701lab/SlaveBMS/Additional cascades (may be useful).brd

## EAGLE design Additional cascades (may be useful).brd (2019-11-22)

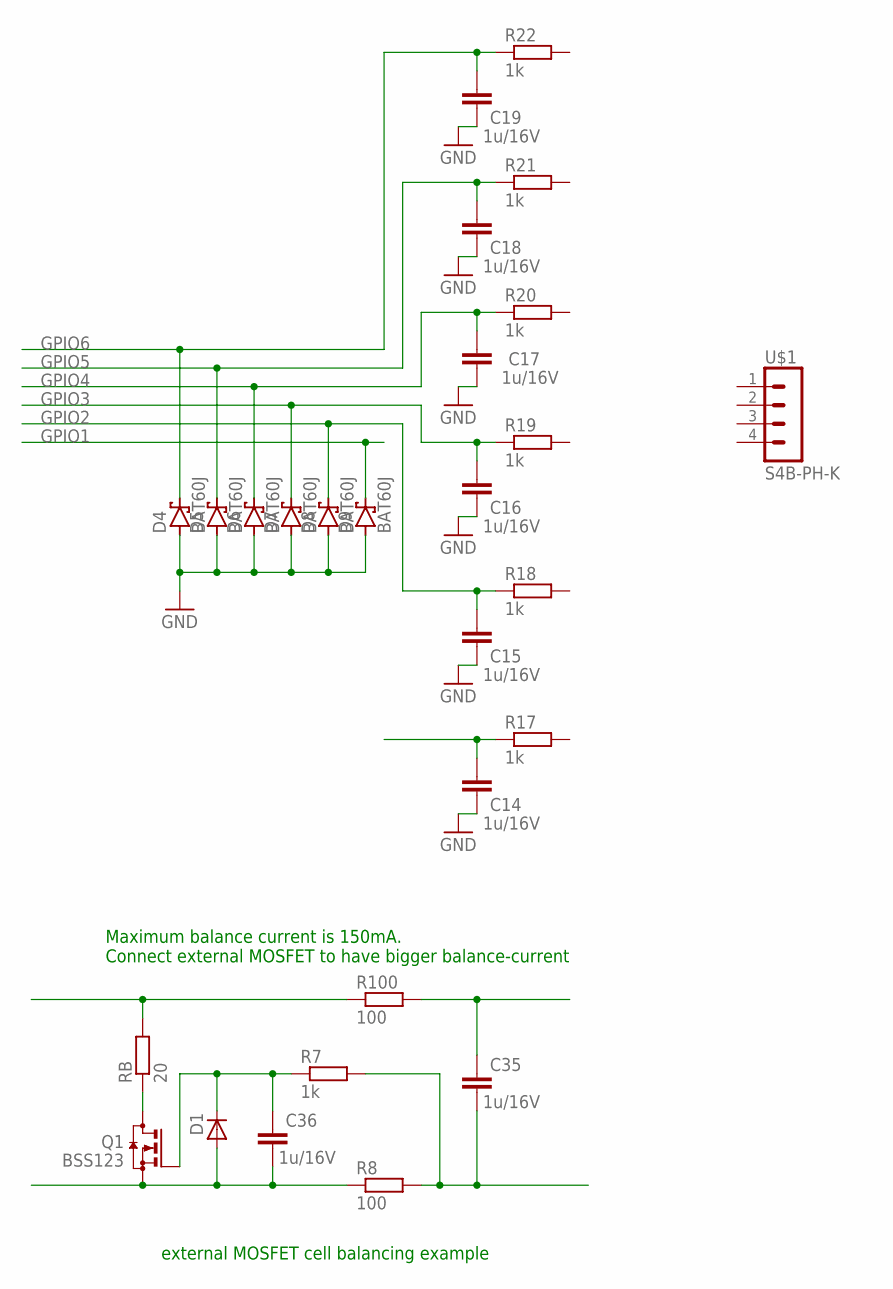
[picture p1: schematic Additional cascades (may be useful).sch]

Parts:
C14, C15, C16, C17, C18, C19, C35, C36: 1u/16V; C0603
D1: DIODE_E-; DIODE_SMB
D4, D5, D6, D7, D8, D9: BAT60J; SOD323_ST
Q1: BSS123; SOT23
R7, R17, R18, R19, R20, R21, R22: 1k; R0603
R8, R100: 100; R0603
RB: 20; R0603
U$1: S4B-PH-K

Connections:
GND: C14.1, C15.1, C16.1, C17.1, C18.1, C19.1, D4.A, D5.A, D6.A, D7.A, D8.A, D9.A
GPIO1: C14.2, D9.C, R17.1
GPIO2: C15.2, D8.C, R18.1
GPIO3: C16.2, D7.C, R19.1
GPIO4: C17.2, D6.C, R20.1
GPIO5: C18.2, D5.C, R21.1
GPIO6: C19.2, D4.C, R22.1
unnamed: Q1.3 (D), RB.1
unnamed: R100.1, RB.2
unnamed: C35.2, R100.2
unnamed: C35.1, R7.2, R8.2
unnamed: C36.1, D1.A (C), Q1.2 (S), R8.1
unnamed: C36.2, D1.C (A), Q1.1 (G), R7.1

Notes on the sheet:
external MOSFET cell balancing example
Maximum balance current is 150mA. Connect external MOSFET to have bigger balance-current

Board: 2 copper layers, 28 parts (0 on the bottom side), 13 nets, no tracks yet.

Other parts of the board:
U$2: BMS_HIGH_COM
