701lab/SlaveBMS/Digital BMS Slave board .brd

## EAGLE design Digital BMS Slave board .brd (2019-11-09)

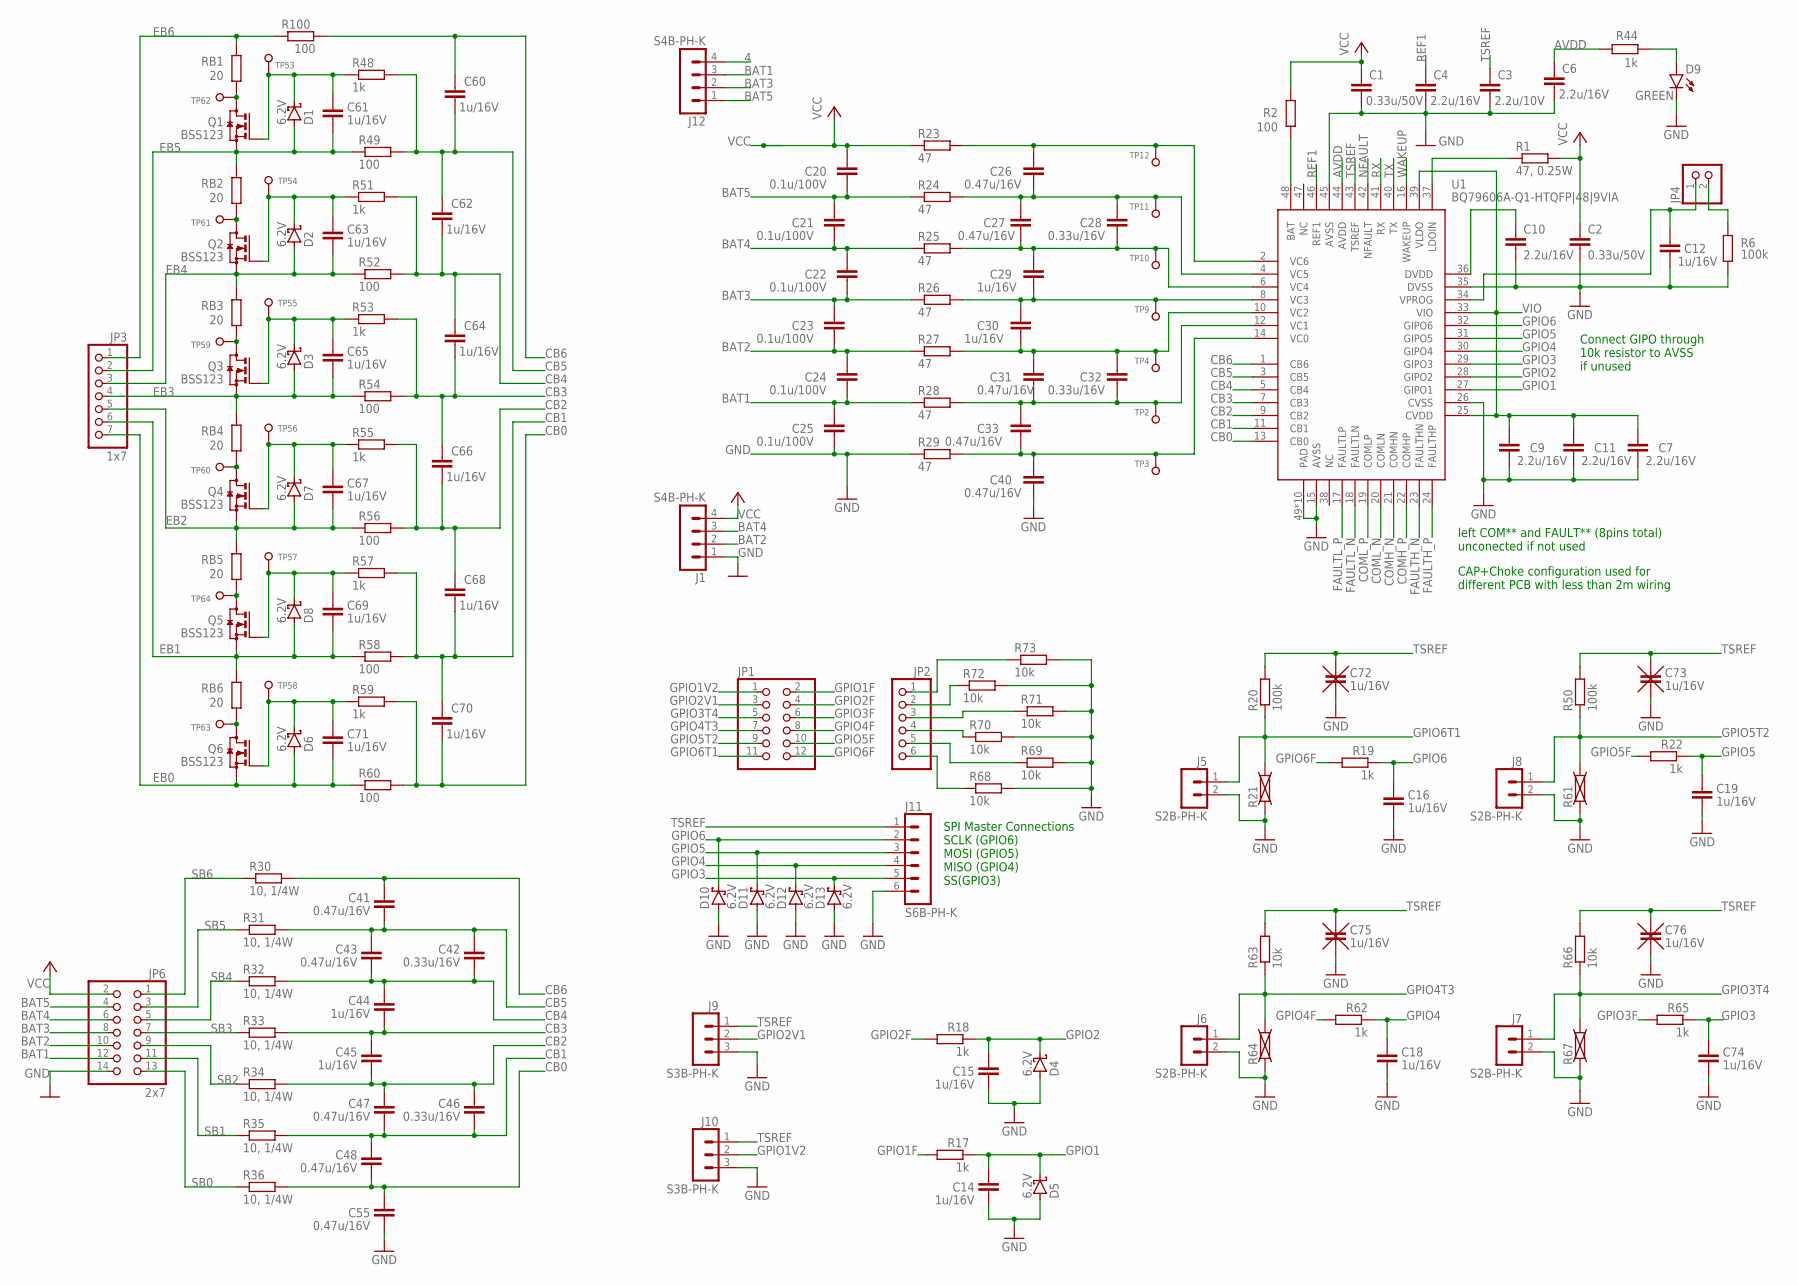
[picture p2: schematic Digital BMS Slave board .sch, sheet 1]

Parts:
C1, C2: 0.33u/50V; C1206K
C3: 2.2u/10V; C0603
C4, C6, C7, C9, C10, C11: 2.2u/16V; C0603
C12, C14, C15, C16, C18, C19, C60, C61, C62, C63, C64, C65, C66, C67, C68, C69, C70, C71, C74: 1u/16V; C0603
C20, C21, C22, C23, C24, C25: 0.1u/100V; C1206K
C26, C27, C31, C33, C40, C41, C43, C47, C48, C55: 0.47u/16V; C0603
C28, C32, C42, C46: 0.33u/16V; C0603
C29, C30, C44, C45: 1u/16V; C0805K
C72, C73, C75, C76: 1u/16V; C0603K-X
D1, D2, D3, D4, D5, D6, D7, D8, D10, D11, D12, D13: 6.2V; SOD323_ST
D9: GREEN; LED-0805
J1, J12: S4B-PH-K
J5, J6, J7, J8: S2B-PH-K
J9, J10: S3B-PH-K
J11: S6B-PH-K
JP1: PINHD-2X6; 2X06
JP2: PINHD-1X6-OCT; 1X06
JP3: 1x7; 1X07
JP4: PINHD-1X2; 1X02
JP6: 2x7; 2X07
Q1, Q2, Q3, Q4, Q5, Q6: BSS123; SOT23
R1: 47, 0.25W; R1206
R2, R49, R52, R54, R56, R58, R60, R100: 100; R0603
R6, R20, R50: 100k; R0603
R17, R18, R19, R22, R44, R48, R51, R53, R55, R57, R59, R62, R65: 1k; R0603
R21, R61, R64, R67: R-EU-X0603; R0603-X
R23, R24, R25, R26, R27, R28, R29: 47; R0603
R30, R31, R32, R33, R34, R35, R36: 10, 1/4W; R1210
R63, R66, R68, R69, R70, R71, R72, R73: 10k; R0603
RB1, RB2, RB3, RB4, RB5, RB6: 20; R2512
TP2, TP3, TP4, TP9, TP10, TP11, TP12: TEST_PAD-[1MM]; TP1MM_MASK
TP53, TP54, TP55, TP56, TP57, TP58, TP59, TP60, TP61, TP62, TP63, TP64: TEST_PAD-[1.27MM]; TP1.27MM
U1: BQ79606A-Q1-HTQFP|48|9VIA; HTQFP48-9X9MM-VIA

Connections:
4: J12.4
AVDD: C6.1, R44.2, U1.44 (AVDD)
BAT: R2.1, U1.48 (BAT)
BAT1: C24.1, C25.2, J12.3, JP6.12, R28.1
BAT2: C23.1, C24.2, J1.2, JP6.10, R27.1
BAT3: C22.1, C23.2, J12.2, JP6.8, R26.1
BAT4: C21.1, C22.2, J1.3, JP6.6, R25.1
BAT5: C20.1, C21.2, J12.1, JP6.4, R24.1
CB0: C48.1, C55.2, C70.1, R36.2, R59.2, R60.2, U1.13 (CB0)
CB1: C46.1, C47.1, C48.2, C68.1, C70.2, R35.2, R57.2, R58.2, U1.11 (CB1)
CB2: C45.1, C46.2, C47.2, C66.1, C68.2, R34.2, R55.2, R56.2, U1.9 (CB2)
CB3: C44.1, C45.2, C64.1, C66.2, R33.2, R53.2, R54.2, U1.7 (CB3)
CB4: C42.1, C43.1, C44.2, C62.1, C64.2, R32.2, R51.2, R52.2, U1.5 (CB4)
CB5: C41.1, C42.2, C43.2, C60.1, C62.2, R31.2, R48.2, R49.2, U1.3 (CB5)
CB6: C41.2, C60.2, R30.2, R100.2, U1.1 (CB6)
COMH_N: U1.21 (COMHN); also elsewhere on the board
COMH_P: U1.22 (COMHP); also elsewhere on the board
COML_N: U1.20 (COMLN); also elsewhere on the board
COML_P: U1.19 (COMLP); also elsewhere on the board
DVDD: C10.1, U1.36 (DVDD)
EB0: C71.1, D6.A, JP3.7, Q6.2 (S), R60.1
EB1: C69.1, D8.A, JP3.6, Q5.2 (S), R58.1, RB6.2
EB2: C67.1, D7.A, JP3.5, Q4.2 (S), R56.1, RB5.2
EB3: C65.1, D3.A, JP3.4, Q3.2 (S), R54.1, RB4.2
EB4: C63.1, D2.A, JP3.3, Q2.2 (S), R52.1, RB3.2
EB5: C61.1, D1.A, JP3.2, Q1.2 (S), R49.1, RB2.2
EB6: JP3.1, R100.1, RB1.2
FAULTH_N: U1.23 (FAULTHN); also elsewhere on the board
FAULTH_P: U1.24 (FAULTHP); also elsewhere on the board
FAULTL_N: U1.18 (FAULTLN); also elsewhere on the board
FAULTL_P: U1.17 (FAULTLP); also elsewhere on the board
GND: C1.1, C2.2, C3.2, C4.2, C6.2, C7.2, C9.2, C10.2, C11.2, C12.2, C14.1, C15.1, C16.1, C18.1, C19.1, C25.1, C40.1, C55.1, C72.2, C73.2, C74.1, C75.2, C76.2, D4.A, D5.A, D9.- (C), D10.A, D11.A, D12.A, D13.A, J1.1, J5.2, J6.2, J7.2, J8.2, J9.3, J10.3, J11.6, JP6.14, R6.1, R21.1, R29.1, R61.1, R64.1, R67.1, R68.2, R69.2, R70.2, R71.2, R72.2, R73.2, U1.15 (AVSS), U1.26 (CVSS), U1.35 (DVSS), U1.45 (AVSS), U1.49 (PAD), U1.491 (PAD), U1.492 (PAD), U1.493 (PAD), U1.494 (PAD), U1.495 (PAD), U1.496 (PAD), U1.497 (PAD), U1.498 (PAD), U1.499 (PAD); also elsewhere on the board
GPIO1: C14.2, D5.C, R17.1, U1.27 (GIPO1)
GPIO1F: JP1.2, R17.2
GPIO1V2: J10.2, JP1.1
GPIO2: C15.2, D4.C, R18.1, U1.28 (GIPO2)
GPIO2F: JP1.4, R18.2
GPIO2V1: J9.2, JP1.3
GPIO3: C74.2, D13.C, J11.5, R65.1, U1.29 (GIPO3)
GPIO3F: JP1.6, R65.2
GPIO3T4: J7.1, JP1.5, R66.1, R67.2
GPIO4: C18.2, D12.C, J11.4, R62.1, U1.30 (GIPO4)
GPIO4F: JP1.8, R62.2
GPIO4T3: J6.1, JP1.7, R63.1, R64.2
GPIO5: C19.2, D11.C, J11.3, R22.1, U1.31 (GIPO5)
GPIO5F: JP1.10, R22.2
GPIO5T2: J8.1, JP1.9, R50.1, R61.2
GPIO6: C16.2, D10.C, J11.2, R19.1, U1.32 (GIPO6)
GPIO6F: JP1.12, R19.2
GPIO6T1: J5.1, JP1.11, R20.1, R21.2
LDOIN: R1.1, U1.37 (LDOIN)
unnamed: JP4.2, R6.2
unnamed: Q1.3 (D), RB1.1, TP62.1
unnamed: JP2.1, R73.1
unnamed: JP2.2, R72.1
unnamed: JP2.3, R71.1
unnamed: JP2.4, R70.1
unnamed: Q3.3 (D), RB3.1, TP59.1
unnamed: JP2.5, R69.1
unnamed: JP2.6, R68.1
unnamed: D9.+ (A), R44.1
unnamed: C61.2, D1.C, Q1.1 (G), R48.1, TP53.1
unnamed: Q2.3 (D), RB2.1, TP61.1
unnamed: Q5.3 (D), RB5.1, TP64.1
unnamed: C63.2, D2.C, Q2.1 (G), R51.1, TP54.1
unnamed: C65.2, D3.C, Q3.1 (G), R53.1, TP55.1
unnamed: Q4.3 (D), RB4.1, TP60.1
unnamed: C67.2, D7.C, Q4.1 (G), R55.1, TP56.1
unnamed: C69.2, D8.C, Q5.1 (G), R57.1, TP57.1
unnamed: Q6.3 (D), RB6.1, TP63.1
unnamed: C71.2, D6.C, Q6.1 (G), R59.1, TP58.1
NFAULT: U1.42 (NFAULT); also elsewhere on the board
REF1: C4.1, U1.46 (REF1)
RX: U1.41 (RX); also elsewhere on the board
SB0: JP6.13, R36.1
SB1: JP6.11, R35.1
SB2: JP6.9, R34.1
SB3: JP6.7, R33.1
SB4: JP6.5, R32.1
SB5: JP6.3, R31.1
SB6: JP6.1, R30.1
TSREF: C3.1, C72.1, C73.1, C75.1, C76.1, J9.1, J10.1, J11.1, R20.2, R50.2, R63.2, R66.2, U1.43 (TSREF)
TX: U1.40 (TX); also elsewhere on the board
VC0: C33.1, C40.2, R29.2, TP3.1, U1.14 (VC0)
VC1: C31.1, C32.1, C33.2, R28.2, TP2.1, U1.12 (VC1)
VC2: C30.1, C31.2, C32.2, R27.2, TP4.1, U1.10 (VC2)
VC3: C29.1, C30.2, R26.2, TP9.1, U1.8 (VC3)
VC4: C27.1, C28.1, C29.2, R25.2, TP10.1, U1.6 (VC4)
VC5: C26.1, C27.2, C28.2, R24.2, TP11.1, U1.4 (VC5)
VC6: C26.2, R23.2, TP12.1, U1.2 (VC6)
VCC: C1.2, C2.1, C20.2, J1.4, JP6.2, R1.2, R2.2, R23.1
VIO: C7.1, C9.1, C11.1, U1.25 (CVDD), U1.33 (VIO), U1.39 (VLDO); also elsewhere on the board
VPROG: C12.1, JP4.1, U1.34 (VPROG)
WAKEUP: U1.16 (WAKEUP); also elsewhere on the board

Notes on the sheet:
Connect GIPO through 10k resistor to AVSS if unused
left COM** and FAULT** (8pins total) unconected if not used
CAP+Choke configuration used for different PCB with less than 2m wiring
SPI Master Connections SCLK (GPIO6) MOSI (GPIO5) MISO (GPIO4) SS(GPIO3)

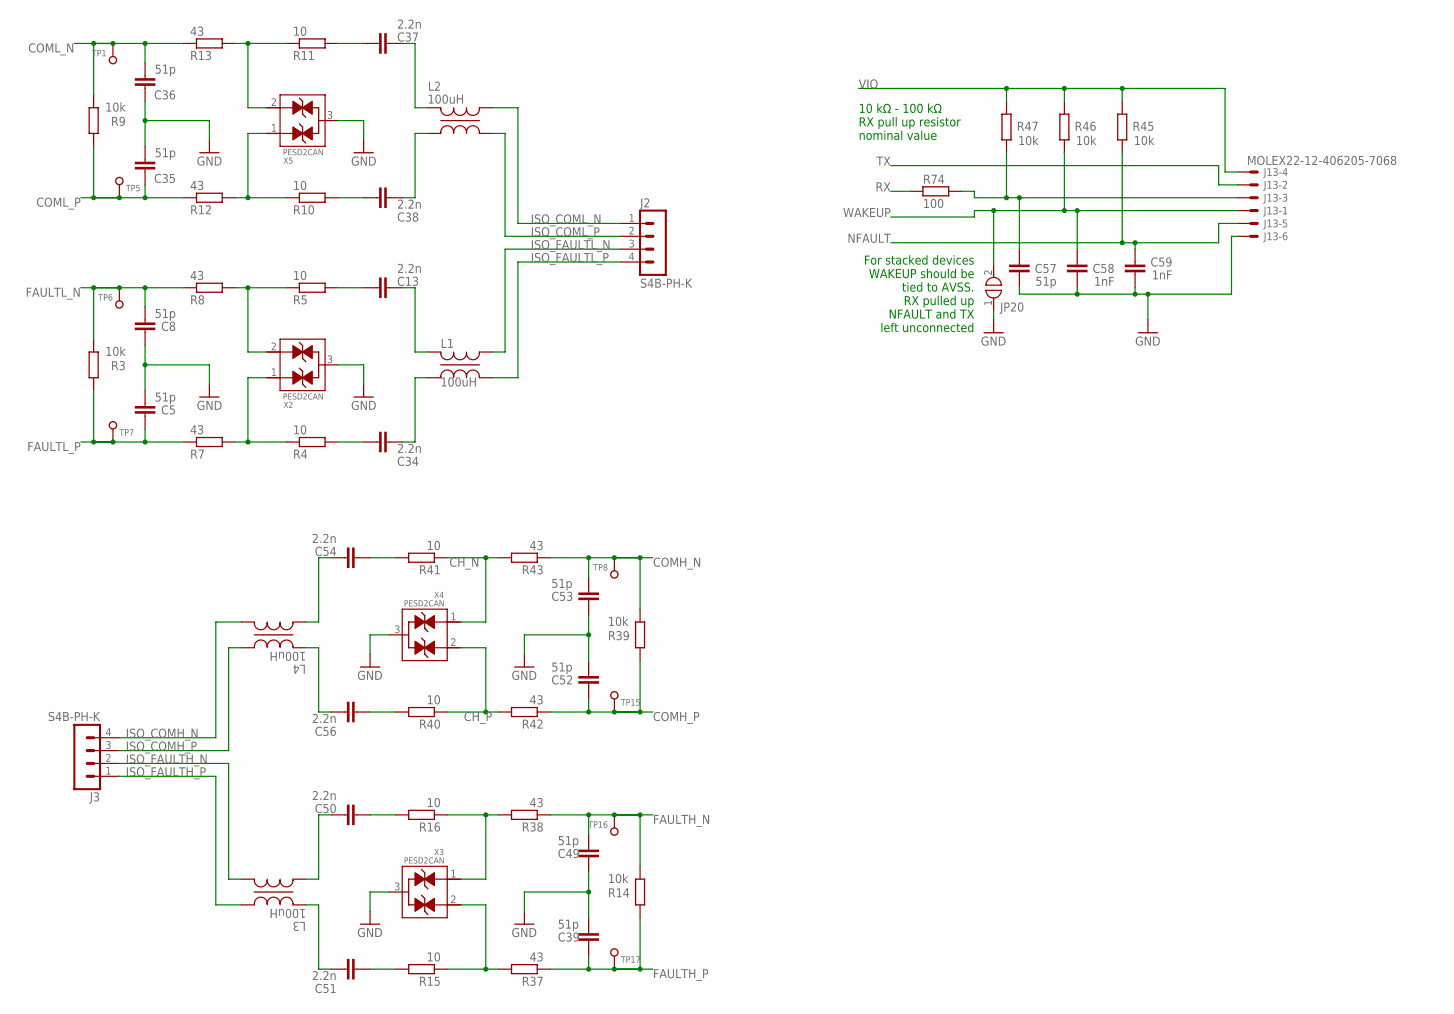
[picture p3: schematic Digital BMS Slave board .sch, sheet 2]

Parts:
C5, C8, C35, C36, C39, C49, C52, C53, C57: 51p; C0603
C13, C34, C37, C38, C50, C51, C54, C56: 2.2n; C1206K
C58, C59: 1nF; C0603
J2, J3: S4B-PH-K
J13: MOLEX22-12-406205-7068; 7395-06
JP20: SOLDER_BRIDGE
L1, L2, L3, L4: 100uH; ACT45B
R3, R9, R14, R39, R45, R46, R47: 10k; R0603
R4, R5, R10, R11, R15, R16, R40, R41: 10; R0603
R7, R8, R12, R13, R37, R38, R42, R43: 43; R0603
R74: 100; R0603
TP1, TP5, TP6, TP7, TP8, TP15, TP16, TP17: TEST_PAD-[1MM]; TP1MM_MASK
X2, X3, X4, X5: PESD2CAN; SOT23

Connections:
CH1_N: C54.2, R41.2
CH1_P: C56.2, R40.2
CH2_N: C54.1, L4.2
CH2_P: C56.1, L4.1
CH_N: R41.1, R43.2, X4.1
CH_P: R40.1, R42.2, X4.2
CL1_N: C37.2, R11.2
CL1_P: C38.2, R10.2
CL2_N: C37.1, L2.1
CL2_P: C38.1, L2.2
CL_N: R11.1, R13.2, X5.2
CL_P: R10.1, R12.2, X5.1
COMH_N: C53.2, R39.1, R43.1, TP8.1; also elsewhere on the board
COMH_P: C52.2, R39.2, R42.1, TP15.1; also elsewhere on the board
COML_N: C36.2, R9.1, R13.1, TP1.1; also elsewhere on the board
COML_P: C35.2, R9.2, R12.1, TP5.1; also elsewhere on the board
FAULTH_N: C49.2, R14.1, R38.1, TP16.1; also elsewhere on the board
FAULTH_P: C39.2, R14.2, R37.1, TP17.1; also elsewhere on the board
FAULTL_N: C8.2, R3.1, R8.1, TP6.1; also elsewhere on the board
FAULTL_P: C5.2, R3.2, R7.1, TP7.1; also elsewhere on the board
FH1_N: C50.2, R16.2
FH1_P: C51.2, R15.2
FH2_N: C50.1, L3.2
FH2_P: C51.1, L3.1
FH_N: R16.1, R38.2, X3.1
FH_P: R15.1, R37.2, X3.2
FL1_N: C13.2, R5.2
FL1_P: C34.2, R4.2
FL2_N: C13.1, L1.1
FL2_P: C34.1, L1.2
FL_N: R5.1, R8.2, X2.2
FL_P: R4.1, R7.2, X2.1
GND: C5.1, C8.1, C35.1, C36.1, C39.1, C49.1, C52.1, C53.1, C57.1, C58.1, C59.1, J13.6, JP20.1, X2.3, X3.3, X4.3, X5.3; also elsewhere on the board
ISO_COMH_N: J3.4, L4.3
ISO_COMH_P: J3.3, L4.4
ISO_COML_N: J2.1, L2.4
ISO_COML_P: J2.2, L2.3
ISO_FAULTH_N: J3.2, L3.3
ISO_FAULTH_P: J3.1, L3.4
ISO_FAULTL_N: J2.3, L1.4
ISO_FAULTL_P: J2.4, L1.3
NFAULT: C59.2, J13.5, R45.1; also elsewhere on the board
RX: R74.2; also elsewhere on the board
RX1: C57.2, J13.3, R47.1, R74.1
TX: J13.2; also elsewhere on the board
VIO: J13.4, R45.2, R46.2, R47.2; also elsewhere on the board
WAKEUP: C58.2, J13.1, JP20.2, R46.1; also elsewhere on the board

Notes on the sheet:
For stacked devices WAKEUP should be tied to AVSS. RX pulled up NFAULT and TX left unconnected
10 kΩ - 100 kΩ RX pull up resistor nominal value

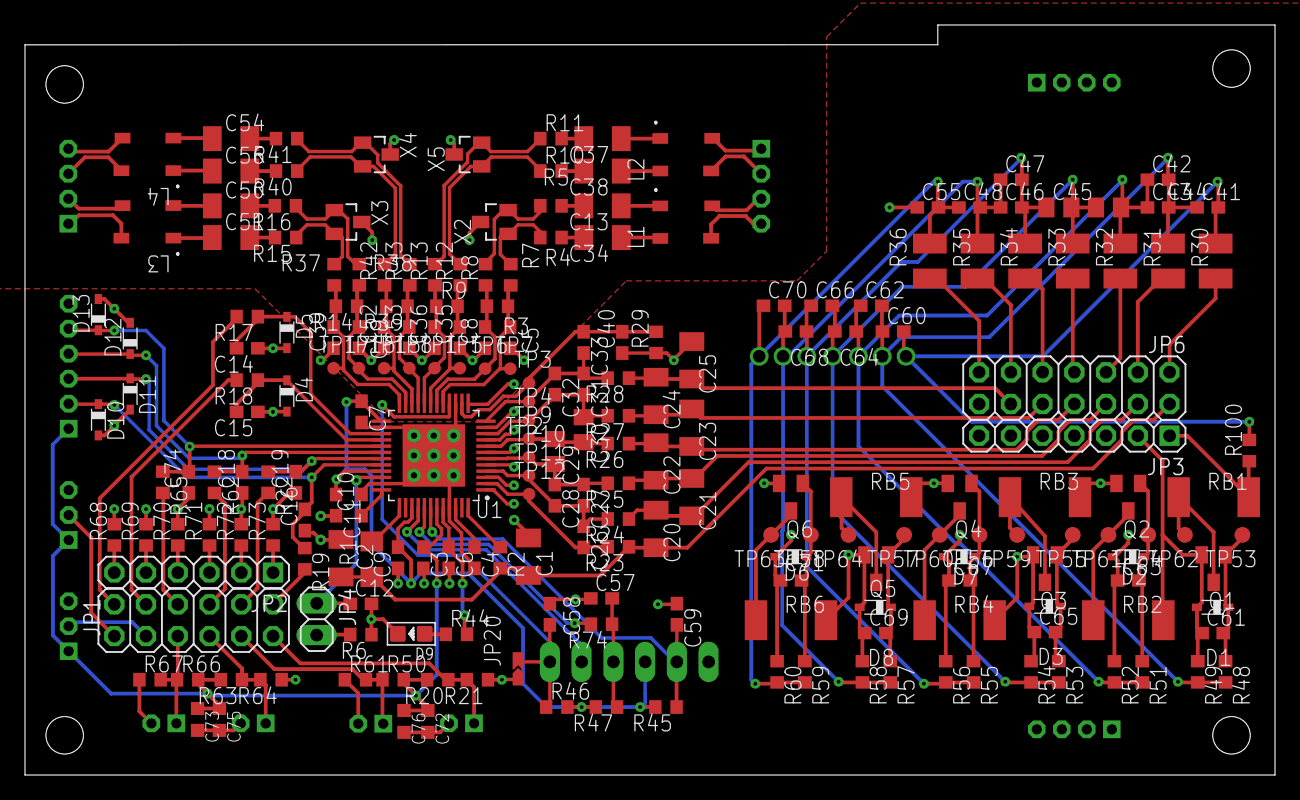
[picture p4: board Digital BMS Slave board .brd from above]

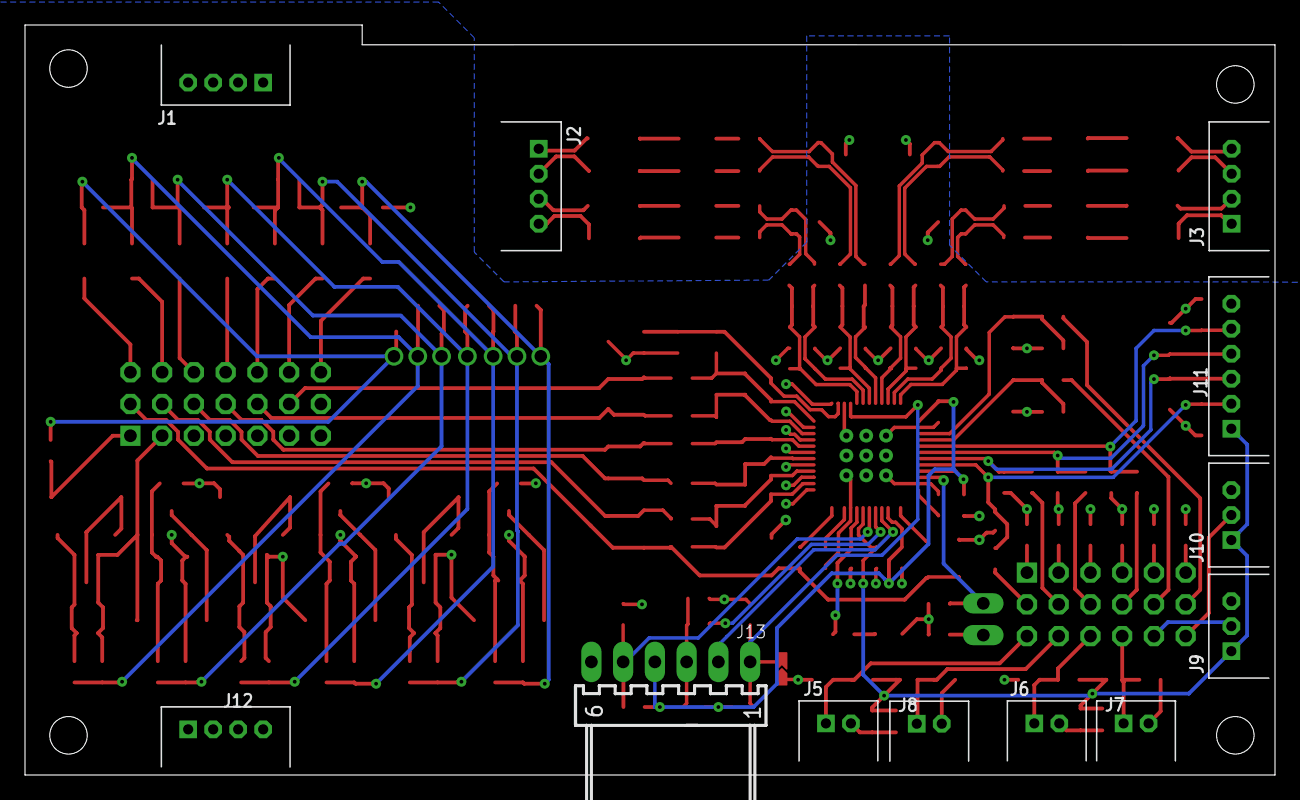
[picture p5: board Digital BMS Slave board .brd from below]

Board: 4 copper layers, 100.0 x 60.0 mm, 229 parts (12 on the bottom side), 126 nets.
