701lab/SlaveBMS/(commit log)

2019-09-09 First Uploading Files
    [Digital BMS Slave board .sch]
2019-09-09 some edits
    [Additional cascades (may be useful).sch, Digital BMS Slave board .brd]
2019-09-21 Board size to chek
    The schematic file is close to release ver.
    [Additional cascades (may be useful).sch, Digital BMS Slave board .brd, Digital BMS Slave board .sch]
2019-09-21 3d models fixed
    [Digital BMS Slave board .brd, Digital BMS Slave board .sch]
2019-10-02 Schematic in accordance with BOM
    [Digital BMS Slave board .brd, Digital BMS Slave board .sch]
2019-10-02 Footprint fixed
    [Digital BMS Slave board .brd, Digital BMS Slave board .sch]
2019-11-04 components placed on board
    [Digital BMS Slave board .brd, Digital BMS Slave board .sch]
2019-11-06 Go home
    [Digital BMS Slave board .brd, Digital BMS Slave board .sch]
2019-11-07 COM and IC CAP routed
    [Digital BMS Slave board .brd, Digital BMS Slave board .sch]
2019-11-08 GPIO routed
    [Digital BMS Slave board .brd, Digital BMS Slave board .sch]
2019-11-09 Full routing 1.0ver. to review
    DRC rules checked
    [Digital BMS Slave board .brd, Digital BMS Slave board .sch]
2019-11-22 Ready to generte GERBER
    Silkscreen+improvements
    [Additional cascades (may be useful).brd, Additional cascades (may be useful).sch, Digital BMS Slave board .sch]
2019-11-28 Some components names changed
    BOM generated
    [Digital BMS Slave board .sch]
2019-12-22 frame with tab routing added
2019-12-24 communication fail correction
    [Digital BMS Slave board .sch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]
2019-12-24 Cam without frame generated
    [copper_bottom_l4.gbr, copper_inner_l2.gbr, copper_inner_l3.gbr, copper_top_l1.gbr, gerber_job.gbrjob, profile.gbr, silkscreen_bottom.gbr, silkscreen_top.gbr]
